tuc-roboschool/Raspibot-Schaltplan/README.md

# Raspibot-Schaltplan
Schaltplan für den TUC-Raspibot
