tuc-roboschool/Raspibot-Schaltplan/Echtzeitsystem.kicad_pcb

## KiCad design Echtzeitsystem.kicad_pcb (2017-06-24)

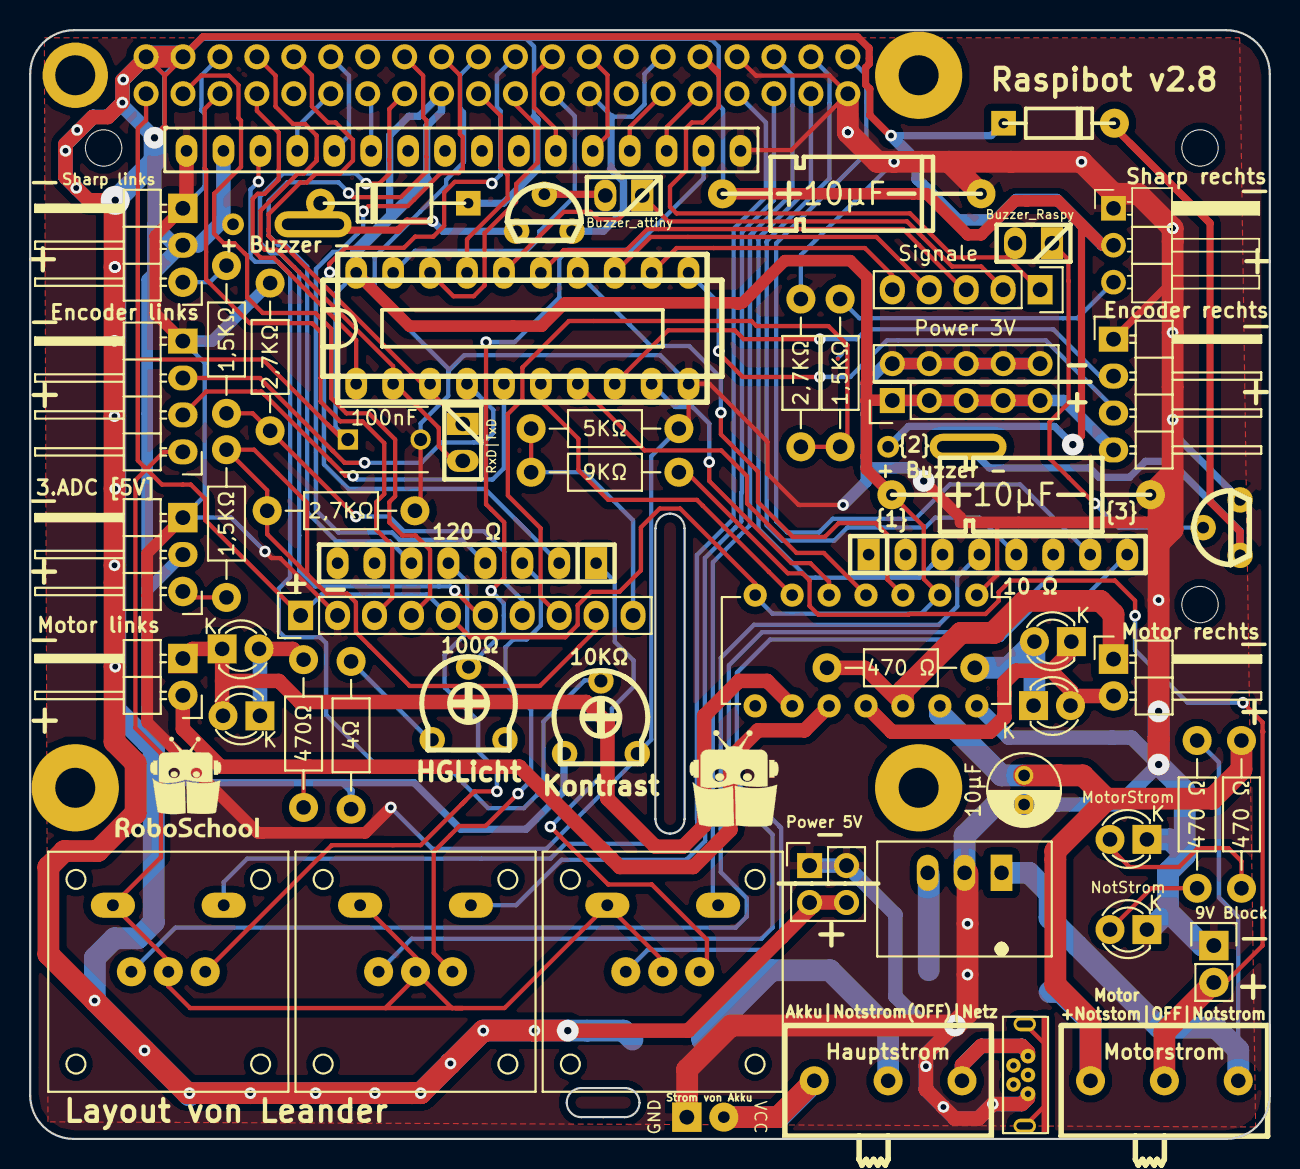
[picture p1: board Echtzeitsystem.kicad_pcb from above]

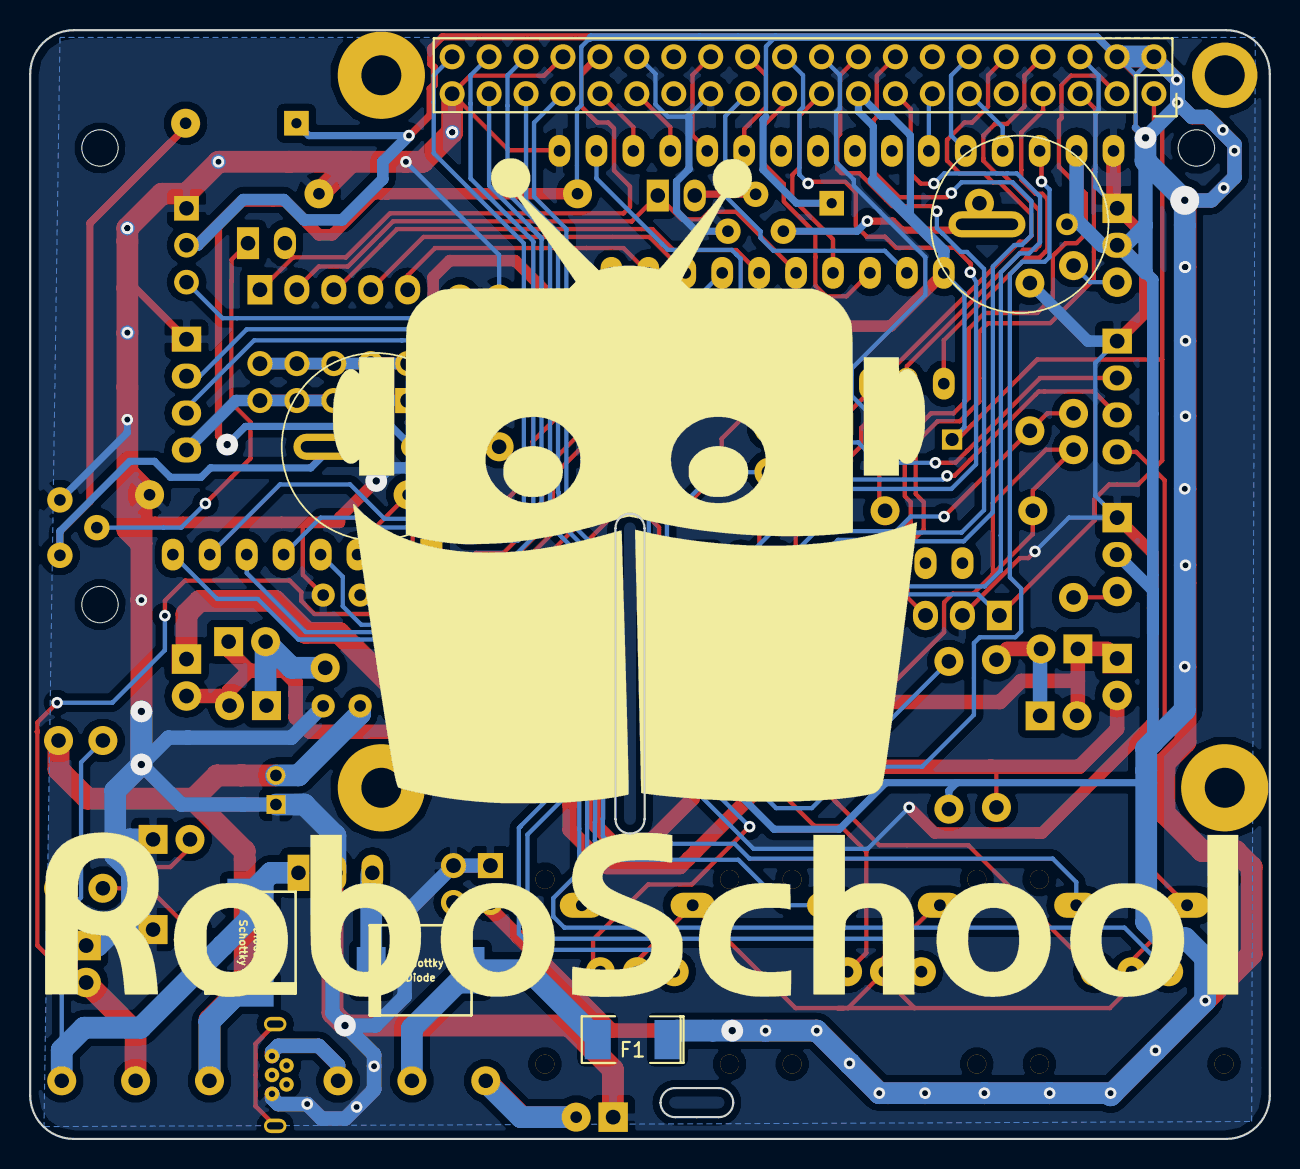
[picture p2: board Echtzeitsystem.kicad_pcb from below]

Board: 2 copper layers, 85.2 x 76.2 mm, 63 parts (7 on the bottom side), 76 nets.

Parts:
3.3VPower1: Power 3V; Pin_Header_Straight_2x05
12VAnschluss1: CONN_01X02; Pin_Header_Straight_1x02
AkkuStrom1: Strom von Akku; SolderWirePad_2x_0-8mmDrill
Attiny1: ATTINY2313A-P; dil_20-300_socket
BZ1: Buzzer; MagneticBuzzer_ProSignal_ABT-410-RC
BZ2: Buzzer; Buzzer_12,7_5mm
C1, C2: 10µF; CPA_5x11MM
C3: 100nF; C_Disc_D6_P5
C5: 10µF; C_Radial_D5_L11_P2
D1, D2, D3: LED_Button2_RG; SW_PUSH-LED-WS-PBTL
D4: NotStrom; LED-3MM
D5, D6, D7, D8, D9: MotorStrom; LED-3MM
D10: DIODE; diode_do41
D11: DIODE; diode_do35
EncoderLinks1: CONN_01X02; Pin_Header_Angled_1x04
EncoderRechts1: CONN_01X02; Pin_Header_Angled_1x04_left
F1: FP_Small; SMD-2010_Pol
J1: Buzzer_attiny; pin_strip_2
J2: Buzzer_Raspy; pin_strip_2
JRXTX: RxD|TxD; pin_strip_2
MotorLinksAusgang1: CONN_01X02; Pin_Header_Angled_1x02
MotorRechtsAusgang1: CONN_01X02; Pin_Header_Angled_1x02_left
Motordriver1: DRV8835; DIP-14_W7.62mm
Netz1: NetzStrom; USB_Micro-B-Stehend
P0: RasPI_IO_Header_B+; Socket_Strip_Straight_2x20
P9: CONN_01X03; Pin_Header_Angled_1x03_left
PololuDisplay1: CONN_02X07; lcd_16x2
Power5: Power 5V; Pin_Header_Straight_2x02
Q1, Q2: Q_NPN_BCE; to92_3
R1, R16, R17: 470 Ω; Resistor_Horizontal_RM10mm
R1-10K1: Kontrast; trimmer_piher_pt6xv
R2: 4Ω; Resistor_Horizontal_RM10mm
R3, R5, R7: 1,5KΩ; Resistor_Horizontal_RM10mm
R4, R6, R8: 2,7KΩ; Resistor_Horizontal_RM10mm
R18: 470Ω; Resistor_Horizontal_RM10mm
R19: 9KΩ; Resistor_Horizontal_RM10mm
R20: 5KΩ; Resistor_Horizontal_RM10mm
R100Ω-200: HGLicht; trimmer_piher_pt6xv
R-GLED2: 10 Ω; r-sil_8
R-RLED2: 120 Ω; r-sil_8
SHARP_ADC0: ADS1015; Socket_Strip_Straight_1x10
SW1, SW2: Switch_Motor_Power; switch_25539N
Schottky: Diode; do214ab
Schottky#2: Diode; do214ab
Sharp_left1: CONN_01X03; Pin_Header_Angled_1x03_left
Sharpright1: CONN_01X03; Pin_Header_Angled_1x03_Pitch2.54mm
Signale1: Signale; Pin_Header_Straight_1x05
U1: MCP1754ST-1802E/MB; DCDC-Conv_TRACO_TSR-1

Connections:
9V-Notstrom: R1.1, SW1.3, Schottky#2.1, U1.1
+3.3V: 3.3VPower1.1, 3.3VPower1.3, 3.3VPower1.5, 3.3VPower1.7, 3.3VPower1.9, Attiny1.20, C1.1, C3.1, D1.2, D1.LC, D2.2, D2.LC, D3.2, D3.LC, EncoderLinks1.4, EncoderRechts1.1, Motordriver1.2, Motordriver1.7, P0.1, P0.17, SHARP_ADC0.1, SHARP_ADC0.5
+5V: BZ1.1, BZ2.1, C2.1, D10.1, D11.1, F1.1, P0.2, P0.4, P9.2, PololuDisplay1.2, Power5.3, Power5.4, R1-10K1.1, R2.2, Sharp_left1.2, Sharpright1.2
+9V: 12VAnschluss1.2, R19.2, SW1.2
/ACD/Batteriespannung?: R19.1, R20.1, SHARP_ADC0.10
/ACD/RechterSharp: R7.1, R8.1, SHARP_ADC0.7
/ACD/linkerSharp: R3.1, R4.1, SHARP_ADC0.8
/AkkuVcc: AkkuStrom1.1, SW2.1
/Attiny/OUTA: Attiny1.11, EncoderLinks1.3
/Attiny/OUTA-R: Attiny1.5, EncoderRechts1.2
/Attiny/OUTB: Attiny1.8, EncoderLinks1.2
/Attiny/OUTB-R: Attiny1.4, EncoderRechts1.3
/LED-Taster/Green-3,2V-1: D1.L2, R-GLED2.6
/LED-Taster/Green-3,2V-2: D2.L2, R-GLED2.4
/LED-Taster/Red-2.4V,2: D2.L1, R-RLED2.5
/LED-Taster/Red-2.4V-1: D1.L1, R-RLED2.3
/LED-Taster/Red-2.4V-3: D3.L1, R-RLED2.1
/NetzVcc: Netz1.1, SW2.3
ALRT-ADC: P0.15, SHARP_ADC0.6
Attiny-Reset: Attiny1.1, P0.7
Attiny-RxD: Attiny1.2, P0.8
Attiny-TxD: Attiny1.3, P0.10
FreierGPIO: J2.2, JRXTX.2, P0.32, Signale1.1
GND: 3.3VPower1.2, 3.3VPower1.4, 3.3VPower1.6, 3.3VPower1.8, 3.3VPower1.10, 12VAnschluss1.1, AkkuStrom1.2, Attiny1.10, C1.2, C2.2, C3.2, C5.2, D4.1, D5.1, EncoderLinks1.1, EncoderRechts1.4, Motordriver1.1, Motordriver1.14, Netz1.5, P0.6, P0.9, P0.14, P0.20, P0.25, P0.30, P0.34, P0.39, P9.3, PololuDisplay1.1, PololuDisplay1.16, Power5.1, Power5.2, Q1.1, Q2.1, R1-10K1.3, R4.2, R6.2, R8.2, R20.2, SHARP_ADC0.2, Sharp_left1.3, Sharpright1.1, U1.2
LEDTASTER1-GREEN: P0.38, R-GLED2.5
LEDTASTER1-RED: P0.18, R-RLED2.4
LEDTASTER1-TASTER: D1.1, P0.35
LEDTASTER2-GREEN: P0.37, R-GLED2.3
LEDTASTER2-RED: P0.16, R-RLED2.6
LEDTASTER2-TASTER: D2.1, P0.33
LEDTASTER3-GREEN: P0.40, R-GLED2.7
LEDTASTER3-RED: P0.22, R-RLED2.2
LEDTASTER3-TASTER: D3.1, P0.36
MISO: Attiny1.18, P0.21
MOSI: Attiny1.17, P0.19
MotorLDIR: Attiny1.7, Motordriver1.4
MotorLPWM: Attiny1.14, Motordriver1.3
MotorRDIR: Attiny1.6, Motordriver1.6
MotorRPWM: Attiny1.9, Motordriver1.5
unnamed: Attiny1.12, Signale1.5
unnamed: Attiny1.13, Signale1.4
unnamed: Attiny1.15, Signale1.3
unnamed: Attiny1.16, J1.1, Signale1.2
unnamed: BZ1.2, D10.2, Q1.3
unnamed: BZ2.2, D11.2, Q2.3
unnamed: C5.1, Motordriver1.13, R16.1, SW1.1, Schottky#2.2
unnamed: D3.L2, R-GLED2.8
unnamed: D4.2, R1.2
unnamed: D5.2, R16.2
unnamed: D6.1, D7.2, MotorLinksAusgang1.2, Motordriver1.11
unnamed: D6.2, D7.1, R17.2
unnamed: D8.1, D9.2, MotorRechtsAusgang1.2, Motordriver1.9
unnamed: D8.2, D9.1, R18.2
unnamed: F1.2, SW2.2, Schottky.1
unnamed: J1.2, Q1.2
unnamed: J2.1, JRXTX.1, Q2.2
unnamed: MotorLinksAusgang1.1, Motordriver1.12, R17.1
unnamed: MotorRechtsAusgang1.1, Motordriver1.10, R18.1
unnamed: P0.11, PololuDisplay1.4
unnamed: P0.12, PololuDisplay1.5
unnamed: P0.13, PololuDisplay1.6
unnamed: P0.24, PololuDisplay1.11
unnamed: P0.26, PololuDisplay1.12
unnamed: P0.29, PololuDisplay1.13
unnamed: P0.31, PololuDisplay1.14
unnamed: P9.1, R5.2
unnamed: PololuDisplay1.3, R1-10K1.2
unnamed: PololuDisplay1.15, R100Ω-200.2
unnamed: R3.2, Sharpright1.3
unnamed: R5.1, R6.1, SHARP_ADC0.9
unnamed: R7.2, Sharp_left1.1
unnamed: R2.1, R100Ω-200.1
unnamed: Schottky.2, U1.3
SCK: Attiny1.19, P0.23
SCL-ADC: P0.5, SHARP_ADC0.3
SDA-ADC: P0.3, SHARP_ADC0.4
